JunjianChi/Smart_Insole_UCL/README.md

# 🦶 Smart Insole System for Gait Sensing and Health Monitoring

> A prototype for plantar pressure measurement for gait analysis

---

## 🖼️ Project Overview
<!-- 建议这里插入一张项目整体图或实物照片 -->
<p align="center">
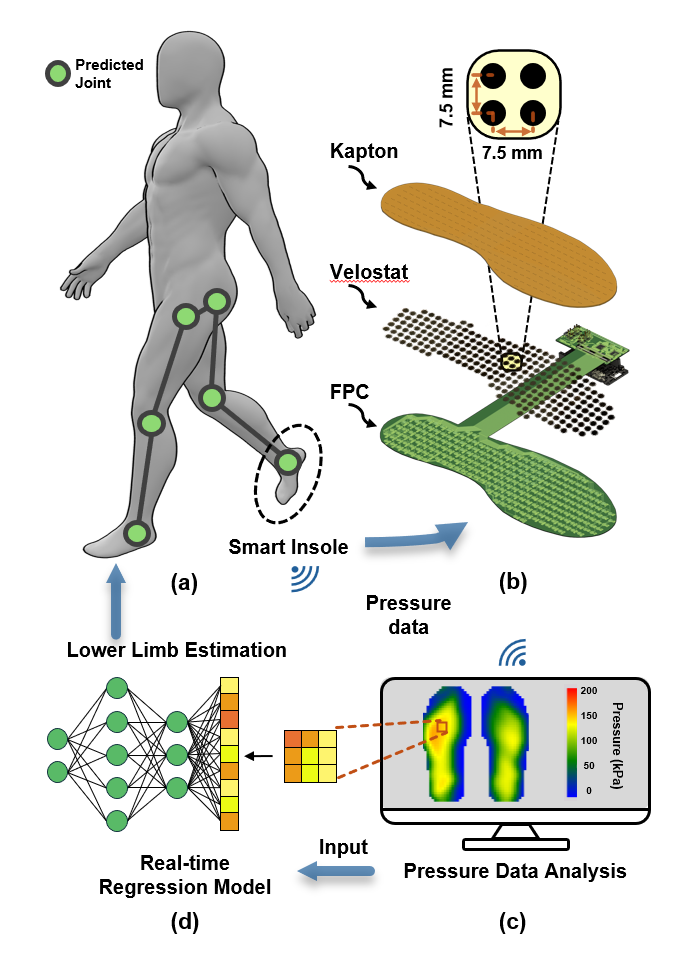
[picture p1: docs/overview.png]
System Overview
  
</p>

This repository contains the **Smart Insole System** project, developed for human gait sensing and health monitoring applications.  
It includes two main design iterations presented at ISCAS 2025 and ISCAS 2026

---

## 📁 Repository Structure

<details>
<summary><code>Git_Insole/</code></summary>

- `README.md`
- `Potential_Divider_Solution/`
  - `PCB/`
  - `Software_Code/`
  - `DataCollection/`
  - `Documents/`
  - `README.md`
- `Double_Sensing_Solution/`
  - `3D_Model/`
  - `DataCollection/`
  - `ESP_MCU_Code/`
  - `Multisim_Simulation/`
  - `PCB/`
  - `WiFi_Server_Code/`
  - `README.md`
- `docs/`

</details>

---

## 🧩 Version Overview

| Version | Year | Core Method | 
|---|---|---|
| **ISCAS 2025** | 2025 | Potential Divider Circuit | 
| **ISCAS 2026** | 2026 | Dual-Sensing  Design |

---
