JunjianChi/Smart_Insole_UCL/Potential_Divider_Solution/PCB/MUX_STACK_ver1/Component/images.png

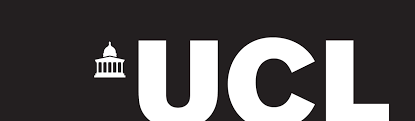
Potential_Divider_Solution/PCB/MUX_STACK_ver1/Component/images.png
