JunjianChi/Smart_Insole_UCL/Double_Sensing_Solution/3D_Model/ISCAS_Diagram_model/fh28d-64s-0_5sh_05_.stp

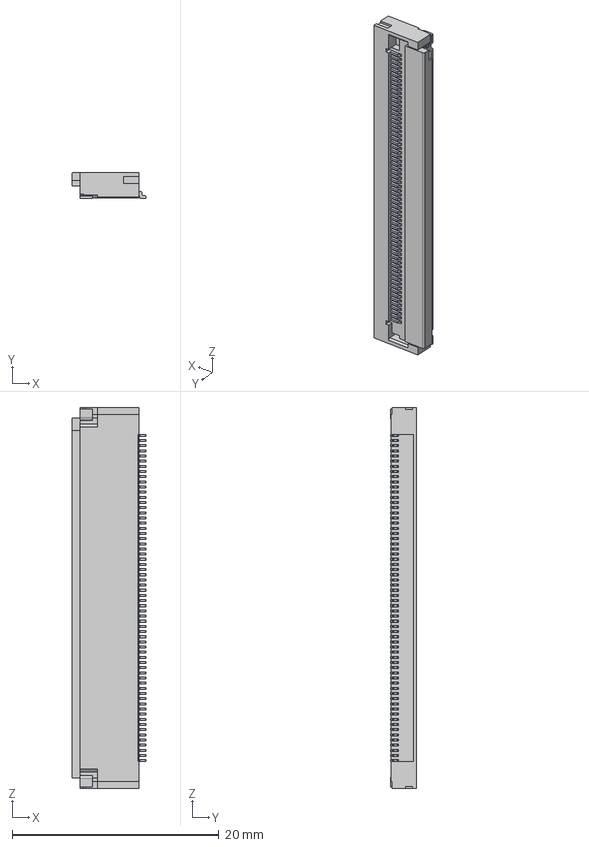
[picture p4: CAD file, 2025-10-31]
Double_Sensing_Solution/3D_Model/ISCAS_Diagram_model/fh28d-64s-0_5sh_05_.stp
7.20 x 2.55 x 36.9 mm
