JunjianChi/Smart_Insole_UCL/Potential_Divider_Solution/PCB/MUX_STACK_ver1/Component/LIB_3313J-1-103E/3313J-1-103E/3D/3313J-1-103E.stp

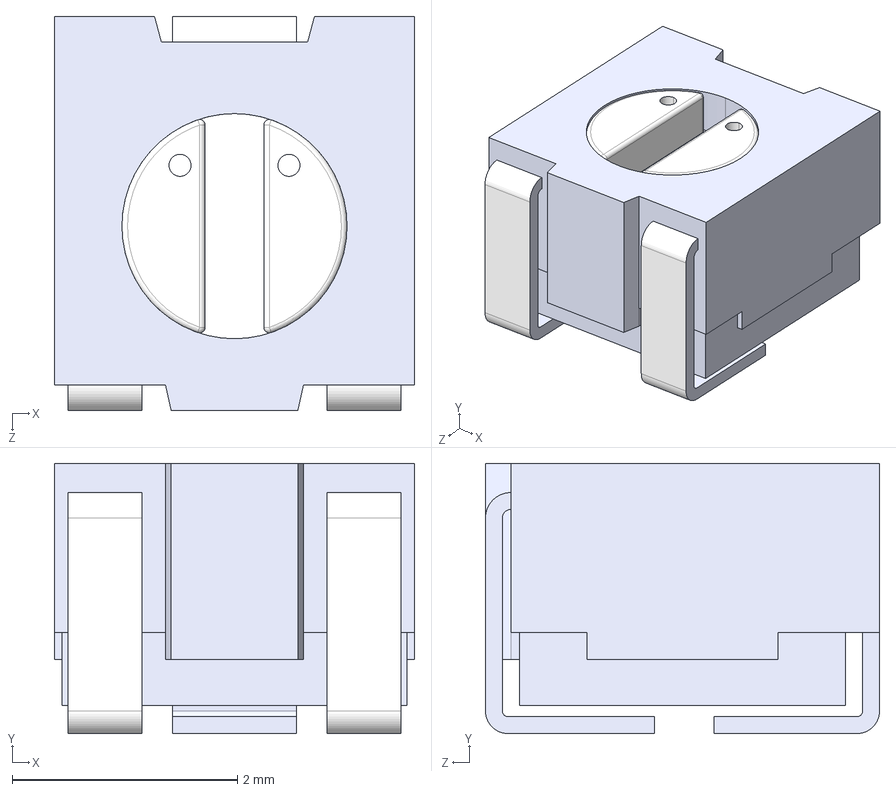
[picture p5: CAD file, 2025-10-31]
Potential_Divider_Solution/PCB/MUX_STACK_ver1/Component/LIB_3313J-1-103E/3313J-1-103E/3D/3313J-1-103E.stp
3.20 x 2.40 x 3.50 mm
