JunjianChi/Smart_Insole_UCL/Potential_Divider_Solution/PCB/MUX_STACK_ver1/Component/LIB_AD8231TCPZ-EP-R7/AD8231TCPZ-EP-R7/3D/AD8231TCPZ-EP-R7.stp

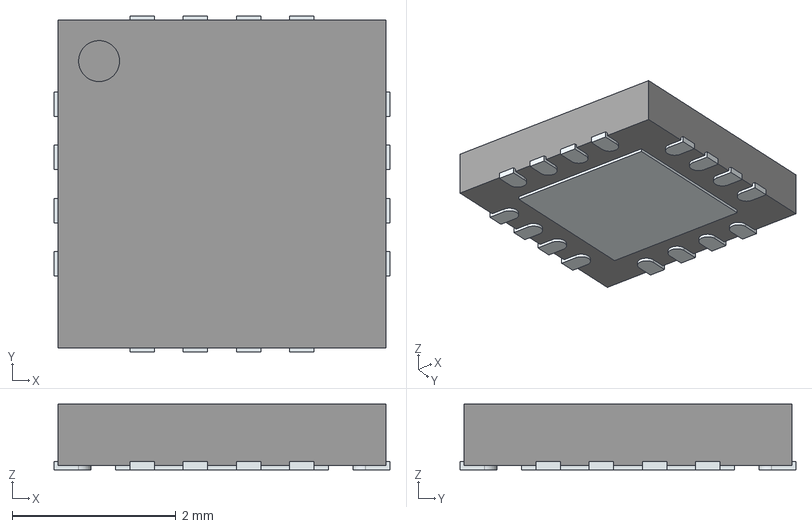
[picture p6: CAD file, 2025-10-31]
Potential_Divider_Solution/PCB/MUX_STACK_ver1/Component/LIB_AD8231TCPZ-EP-R7/AD8231TCPZ-EP-R7/3D/AD8231TCPZ-EP-R7.stp
4.10 x 4.10 x 0.8 mm
ThermalPin
PinsArrayLR
PinsArrayTB
