JunjianChi/Smart_Insole_UCL/Potential_Divider_Solution/PCB/MUX_STACK_ver1/Component/LIB_AD8615AUJZ-REEL7/AD8615AUJZ-REEL7/3D/AD8615AUJZ-REEL7.stp

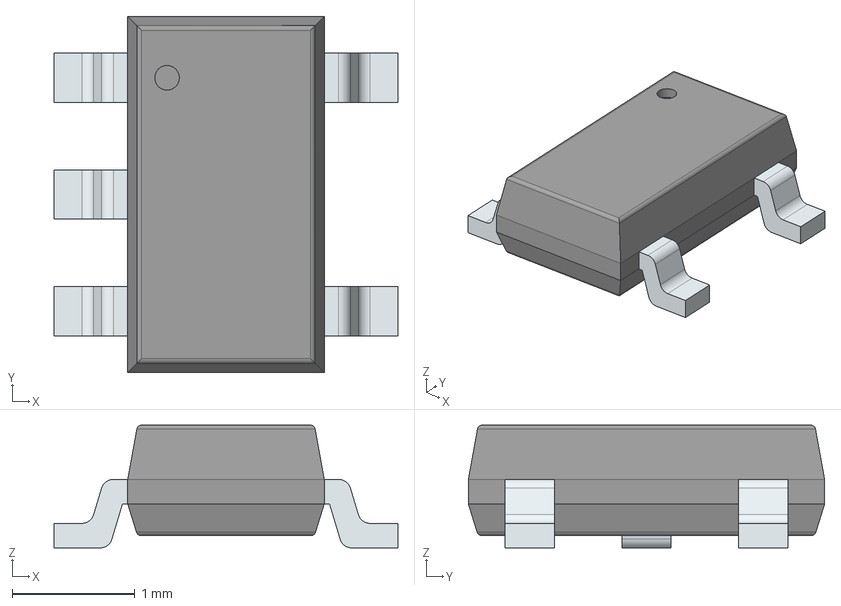
[picture p7: CAD file, 2025-10-31]
Potential_Divider_Solution/PCB/MUX_STACK_ver1/Component/LIB_AD8615AUJZ-REEL7/AD8615AUJZ-REEL7/3D/AD8615AUJZ-REEL7.stp
2.80 x 2.90 x 1.00 mm
PinsArrayL
PinsArrayR
