JunjianChi/Smart_Insole_UCL/Potential_Divider_Solution/PCB/MUX_STACK_ver1/Component/LIB_ADG732BSUZ-REEL/ADG732BSUZ-REEL/3D/ADG732BSUZ-REEL.stp

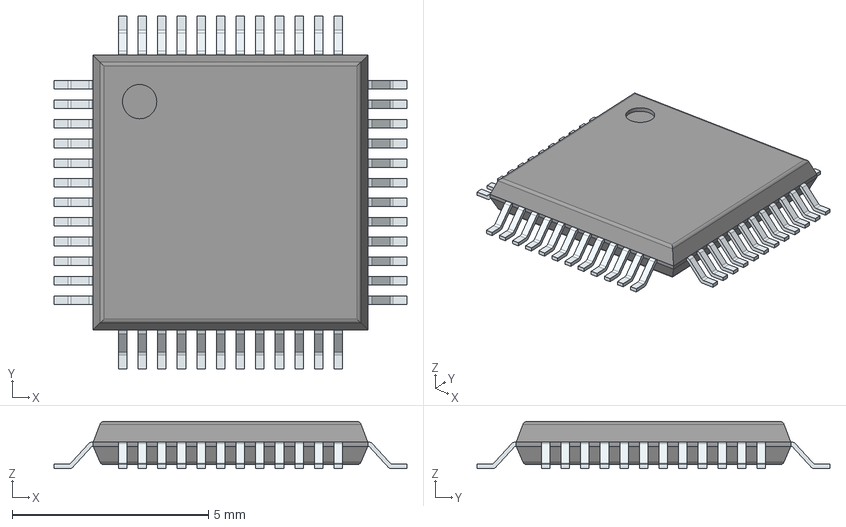
[picture p8: CAD file, 2025-10-31]
Potential_Divider_Solution/PCB/MUX_STACK_ver1/Component/LIB_ADG732BSUZ-REEL/ADG732BSUZ-REEL/3D/ADG732BSUZ-REEL.stp
9.00 x 9.00 x 1.20 mm
PinsArrayLR
PinsArrayTB
