JunjianChi/Smart_Insole_UCL/Double_Sensing_Solution/3D_Model/ISCAS_Diagram_model/ADG732BSUZ--3DModel-STEP-269445.STEP

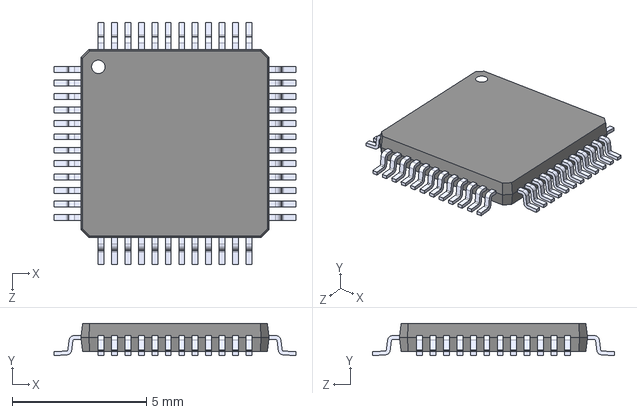
[picture p9: CAD file, 2025-10-31]
Double_Sensing_Solution/3D_Model/ISCAS_Diagram_model/ADG732BSUZ--3DModel-STEP-269445.STEP
9.00 x 1.20 x 9.00 mm
