JunjianChi/Smart_Insole_UCL/(list of files, cad)

Other CAD files:
Double_Sensing_Solution/3D_Model/shoe_stl/Shoe_1mm_thickness.stl
Potential_Divider_Solution/PCB/MUX_STACK_ver1/Component/LIB_3313J-1-103E/3313J-1-103E/Allegro/3313j1103e.psm
Potential_Divider_Solution/PCB/MUX_STACK_ver1/Component/LIB_3313J-1-103E/3313J-1-103E/DEHDL/3313j_1_103e/chips/chips.prt
Potential_Divider_Solution/PCB/MUX_STACK_ver1/Component/LIB_AD8231TCPZ-EP-R7/AD8231TCPZ-EP-R7/Allegro/qfn65p400x400x80-17n-d.psm
Potential_Divider_Solution/PCB/MUX_STACK_ver1/Component/LIB_AD8231TCPZ-EP-R7/AD8231TCPZ-EP-R7/DEHDL/ad8231tcpz_ep_r7/chips/chips.prt
Potential_Divider_Solution/PCB/MUX_STACK_ver1/Component/LIB_AD8615AUJZ-REEL7/AD8615AUJZ-REEL7/Allegro/sot95p280x100-5n.psm
Potential_Divider_Solution/PCB/MUX_STACK_ver1/Component/LIB_AD8615AUJZ-REEL7/AD8615AUJZ-REEL7/DEHDL/ad8615aujz_reel7/chips/chips.prt
Potential_Divider_Solution/PCB/MUX_STACK_ver1/Component/LIB_ADG732BSUZ-REEL/ADG732BSUZ-REEL/Allegro/qfp50p900x900x120-48n.psm
Potential_Divider_Solution/PCB/MUX_STACK_ver1/Component/LIB_ADG732BSUZ-REEL/ADG732BSUZ-REEL/DEHDL/adg732bsuz_reel/chips/chips.prt
