JunjianChi/Smart_Insole_UCL/(list of files, drawings)

Other design files:
Double_Sensing_Solution/Multisim_Simulation/resistor_network.ms14
Double_Sensing_Solution/Multisim_Simulation/resistor_network_diode.ms14
Double_Sensing_Solution/PCB/Dip_Laser_Cut/Insole_42.dip
Double_Sensing_Solution/PCB/Dip_Laser_Cut/MAT_32.dip
Double_Sensing_Solution/PCB/Insole_MCU/Insole_MCU.SchDoc
Double_Sensing_Solution/PCB/Insole_ver2/Insole_ver2.PcbDoc
Double_Sensing_Solution/PCB/Insole_ver2/Insole_ver2.SchDoc
Potential_Divider_Solution/PCB/Dip_Laser_Cut/Insole_42.dip
Potential_Divider_Solution/PCB/Dip_Laser_Cut/MAT_32.dip
Potential_Divider_Solution/PCB/Insole_ver1/Insole_ver1.PcbDoc
Potential_Divider_Solution/PCB/Insole_ver1/Insole_ver1_chi.SchDoc
Potential_Divider_Solution/PCB/MUX_STACK_ver1/Component/8.15A0.0642001_8.15A0.064200.schdoc.schdoc
Potential_Divider_Solution/PCB/MUX_STACK_ver1/Component/FPC-SMD_64P-P0.50_8.15A0.064200.pcbdoc
Potential_Divider_Solution/PCB/MUX_STACK_ver1/Component/FPC_64.PcbLib
Potential_Divider_Solution/PCB/MUX_STACK_ver1/Component/LIB_3313J-1-103E/3313J-1-103E/Altium/3313J1103E.PcbLib
Potential_Divider_Solution/PCB/MUX_STACK_ver1/Component/LIB_3313J-1-103E/3313J-1-103E/Altium/3313J-1-103E.SchLib
Potential_Divider_Solution/PCB/MUX_STACK_ver1/Component/LIB_AD8231TCPZ-EP-R7/AD8231TCPZ-EP-R7/Altium/AD8231TCPZ-EP-R7.SchLib
Potential_Divider_Solution/PCB/MUX_STACK_ver1/Component/LIB_AD8231TCPZ-EP-R7/AD8231TCPZ-EP-R7/Altium/QFN65P400X400X80-17N-D.PcbLib
Potential_Divider_Solution/PCB/MUX_STACK_ver1/Component/LIB_AD8615AUJZ-REEL7/AD8615AUJZ-REEL7/Altium/AD8615AUJZ-REEL7.SchLib
Potential_Divider_Solution/PCB/MUX_STACK_ver1/Component/LIB_AD8615AUJZ-REEL7/AD8615AUJZ-REEL7/Altium/SOT95P280X100-5N.PcbLib
Potential_Divider_Solution/PCB/MUX_STACK_ver1/Component/LIB_ADG732BSUZ-REEL/ADG732BSUZ-REEL/Altium/ADG732BSUZ-REEL.SchLib
Potential_Divider_Solution/PCB/MUX_STACK_ver1/Component/LIB_ADG732BSUZ-REEL/ADG732BSUZ-REEL/Altium/QFP50P900X900X120-48N.PcbLib
Potential_Divider_Solution/PCB/MUX_STACK_ver1/mux_stack_espE.SchDoc
Potential_Divider_Solution/PCB/MUX_STACK_ver1/mux_stack_espE_64pin.PcbDoc
Potential_Divider_Solution/PCB/MUX_STACK_ver1/Simulation_circuit/ADC_test_circuit.ms14
Potential_Divider_Solution/PCB/MUX_STACK_ver1/Simulation_circuit/Design2.ms14
